TheCacophonyProject/power-bank-enabler/CacophenablerKiCad/48037-2200.stp

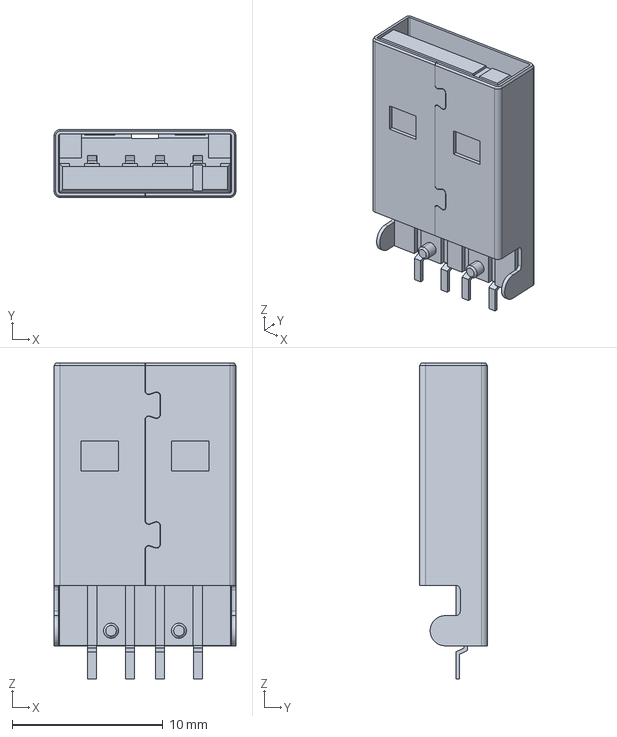
[picture p1: CAD file, 2019-10-01]
CacophenablerKiCad/48037-2200.stp
12.1 x 4.50 x 21.0 mm
