TheCacophonyProject/power-bank-enabler/CacophenablerKiCad/CacPP_PIC10.kicad_pcb

## KiCad design CacophenablerKiCad/CacPP_PIC10.kicad_pcb (2019-10-01)

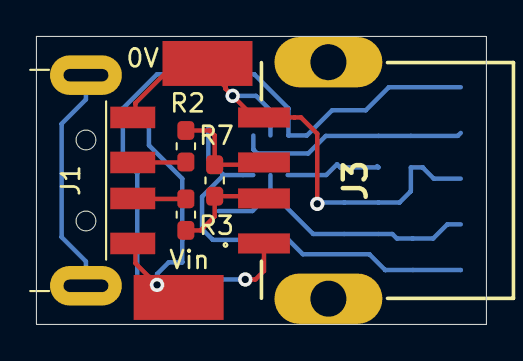
[picture p2: board CacPP_PIC10.kicad_pcb from above]

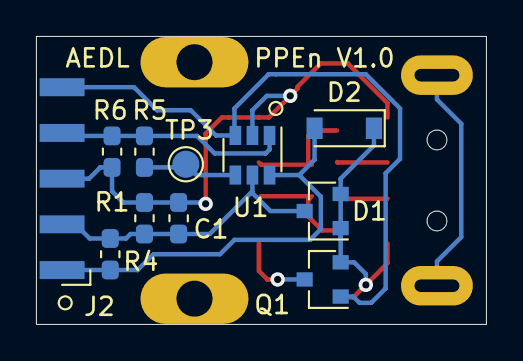
[picture p3: board CacPP_PIC10.kicad_pcb from below]

Board: 2 copper layers, 25.0 x 16.0 mm, 18 parts (11 on the bottom side), 12 nets.

Parts:
0V: 0V_in; SolderWirePad_1x01_SMD_1.5x5mm
C1: 1uF 10V; C_0603_1608Metric_Pad1.05x0.95mm_HandSolder
D1: BAT54C; SOT-23
D2: 1N4148; D_SOD-123
J1: USB_A; USB_A_Molex_48037_2200
J2: ICSP interface; Harwin_M20-89005xx_1x05_P2.54mm_Horizontal
J3: 2410_06
Q1: FDN340P; SOT-23
R1: 4M7; R_0603_1608Metric_Pad1.05x0.95mm_HandSolder
R2, R3: 0 NF; R_0603_1608Metric_Pad1.05x0.95mm_HandSolder
R4, R5: 10K NF; R_0603_1608Metric_Pad1.05x0.95mm_HandSolder
R6: 100K; R_0603_1608Metric_Pad1.05x0.95mm_HandSolder
R7: 200; R_0603_1608Metric_Pad1.05x0.95mm_HandSolder
TP3: Debug; TestPoint_Pad_D1.5mm
U1: PIC10F220-IOT; SOT-23-6
Vin: Vin; SolderWirePad_1x01_SMD_1.5x5mm

Connections:
/AN0: J2.4, R5.2, R6.1, U1.1
/DEBUG: R5.1, TP3.1, U1.4
/ICSPCLK: J2.5, Q1.1, U1.3
/MCLR: D2.2, J2.1, R4.1, U1.6
/VCC: C1.1, D1.3, J2.2, R1.1, R4.2, U1.5
/Vin: D1.1, D1.2, D2.1, J1.1, Q1.2, Vin.1
/Vout: J3.1, Q1.3
GND: 0V.1, C1.2, J1.4, J2.3, J3.4, R1.2, R6.2, U1.2
unnamed: J1.2, R3.2
unnamed: J1.3, R2.2
unnamed: J3.2, R3.1, R7.1
unnamed: J3.3, R2.1, R7.2
